Inud/Position-Detector-HCSR04-Verilog-DE1/note.txt

diffClock block: cambio control nel main e nell'if di diffClock
main: aggiunto [31:0] al alla riga collegamenti nel
